rn-t/rogy-cnc-controller/PCB/cnc-controller.pdf

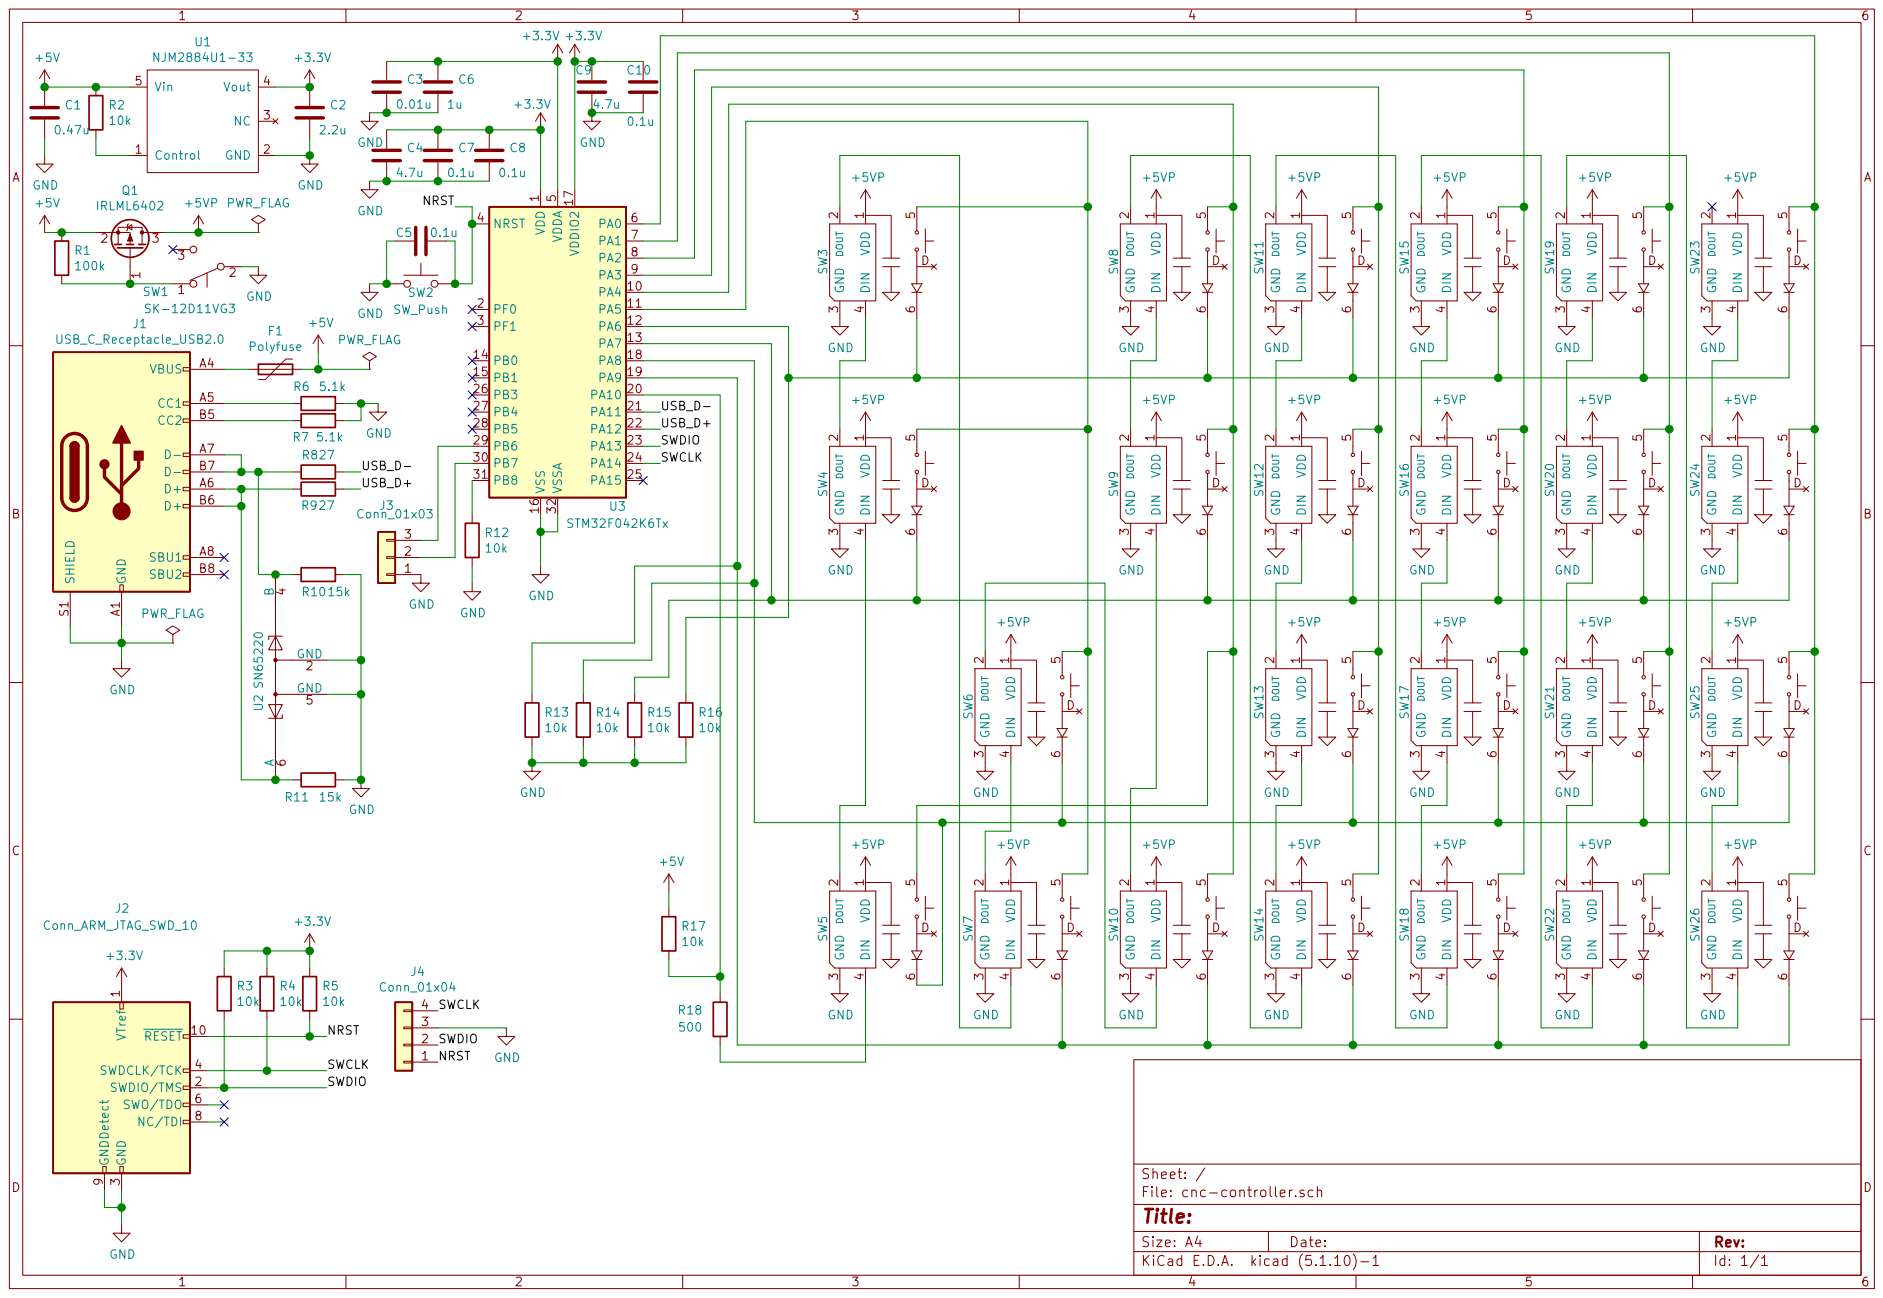
[picture p1: page 1]

Id: 1/1 Title: File: cnc-controller.sch Sheet: /
