rn-t/rogy-cnc-controller/PCB/cnc-controller.kicad_pcb

## KiCad design PCB/cnc-controller.kicad_pcb (2021-09-07)

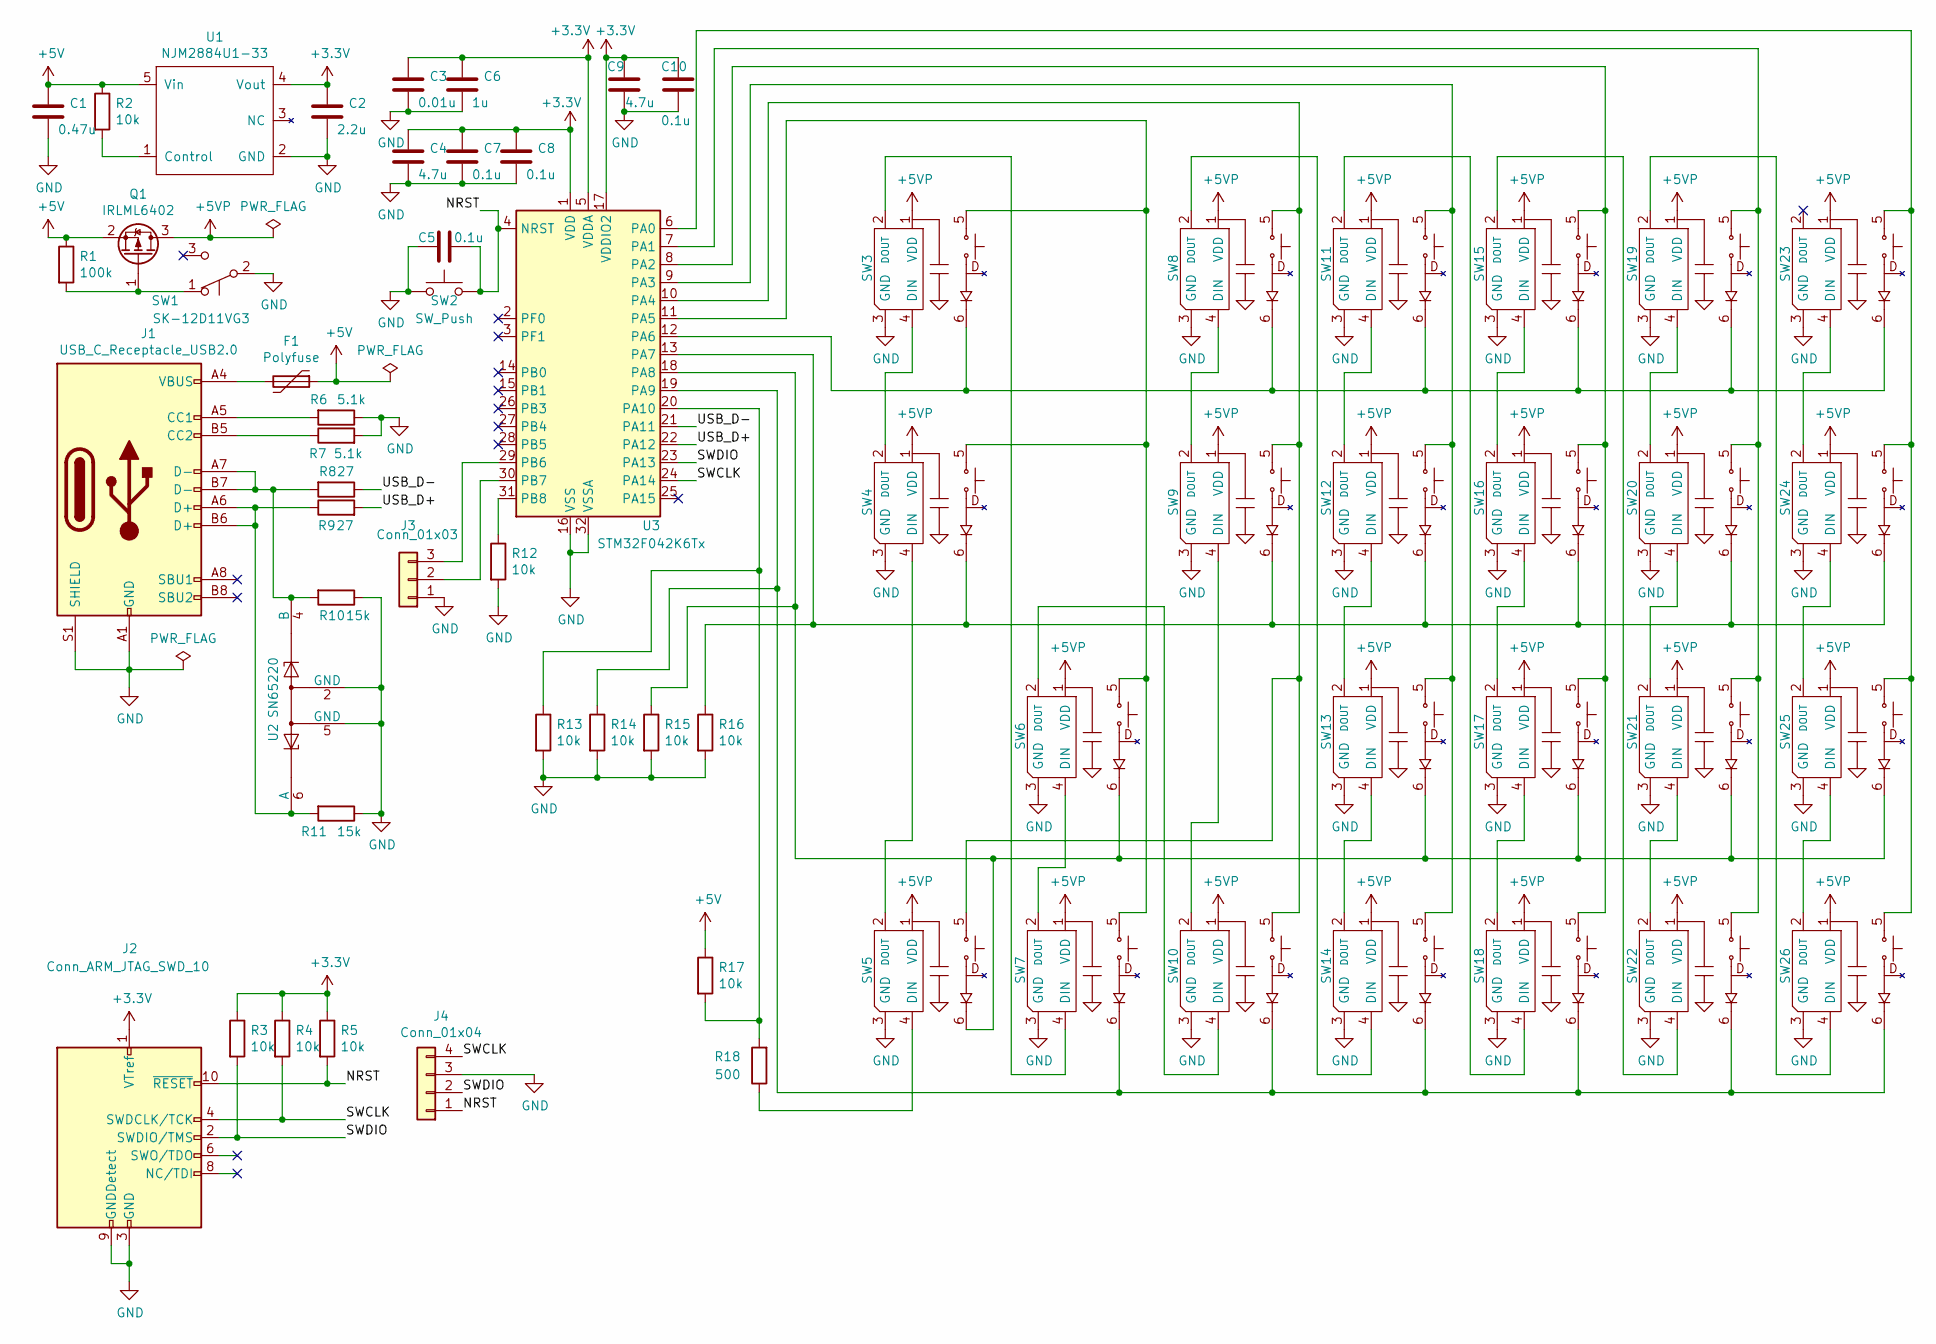
[picture p2: schematic cnc-controller.sch]

Parts:
C1: 0.47u; C_0402_1005Metric_Pad0.74x0.62mm_HandSolder
C2: 2.2u; C_0805_2012Metric_Pad1.18x1.45mm_HandSolder
C3: 0.01u; C_0603_1608Metric_Pad1.08x0.95mm_HandSolder
C4, C9: 4.7u; C_0603_1608Metric_Pad1.08x0.95mm_HandSolder
C5, C7, C8, C10: 0.1u; C_0603_1608Metric_Pad1.08x0.95mm_HandSolder
C6: 1u; C_0603_1608Metric_Pad1.08x0.95mm_HandSolder
F1: Polyfuse; Fuse_0603_1608Metric_Pad1.05x0.95mm_HandSolder
J1: USB_C_Receptacle_USB2.0; USBC_5077CR-16-SMC2-BK-TR
J2: Conn_ARM_JTAG_SWD_10; PinHeader_2x05_P1.27mm_Vertical
J3: Conn_01x03; PinHeader_1x03_P2.54mm_Vertical
J4: Conn_01x04; PinHeader_1x04_P2.54mm_Vertical
Q1: IRLML6402; SOT-23
R1: 100k; R_0603_1608Metric_Pad0.98x0.95mm_HandSolder
R2, R3, R4, R5, R12, R13, R14, R15, R16, R17: 10k; R_0603_1608Metric_Pad0.98x0.95mm_HandSolder
R6, R7: 5.1k; R_0603_1608Metric_Pad0.98x0.95mm_HandSolder
R8, R9: 27; R_0603_1608Metric_Pad0.98x0.95mm_HandSolder
R10, R11: 15k; R_0603_1608Metric_Pad0.98x0.95mm_HandSolder
R18: 500; R_0603_1608Metric_Pad0.98x0.95mm_HandSolder
SW1: SK-12D11VG3; SW_SK-12D11VG3
SW2: SW_Push; SW_TVBP06-B043CB-B
SW3, SW4, SW5, SW6, SW7, SW8, SW9, SW10, SW11, SW12, SW13, SW14, SW15, SW16, SW17, SW18, SW19, SW20, SW21, SW22, SW23, SW24, SW25, SW26: sw_unit; kailh_chocv1_unit
U1: NJM2884U1-33; SOT-89-5_Handsoldering
U2: SN65220; SOT-23-6
U3: STM32F042K6Tx; LQFP-32_7x7mm_P0.8mm

Connections:
+3V3: C2.1, C3.1, C4.1, C6.1, C7.1, C8.1, C9.1, C10.1, J2.1 (VTref), R3.1, R4.1, R5.1, U1.4 (Vout), U3.1 (VDD), U3.5 (VDDA), U3.17 (VDDIO2); also elsewhere on the board
+5V: C1.1, F1.1, Q1.2 (S), R1.1, R2.1, R17.1, U1.5 (Vin)
+5VP: Q1.3 (D), SW3.1 (VDD), SW4.1 (VDD), SW5.1 (VDD), SW6.1 (VDD), SW7.1 (VDD), SW8.1 (VDD), SW9.1 (VDD), SW10.1 (VDD), SW11.1 (VDD), SW12.1 (VDD), SW13.1 (VDD), SW14.1 (VDD), SW15.1 (VDD), SW16.1 (VDD), SW17.1 (VDD), SW18.1 (VDD), SW19.1 (VDD), SW20.1 (VDD), SW21.1 (VDD), SW22.1 (VDD), SW23.1 (VDD), SW24.1 (VDD), SW25.1 (VDD), SW26.1 (VDD)
/NRST: C5.1, J2.10 (~RESET~), J4.1, R5.2, SW2.2, U3.4 (NRST); also elsewhere on the board
/SWCLK: J2.4 (SWDCLK/TCK), J4.4, R4.2, U3.24 (PA14); also elsewhere on the board
/SWDIO: J2.2 (SWDIO/TMS), J4.2, R3.2, U3.23 (PA13); also elsewhere on the board
/USB_D+: R9.2, U3.22 (PA12)
/USB_D-: R8.1, U3.21 (PA11)
GND: C1.2, C2.2, C3.2, C4.2, C5.2, C6.2, C7.2, C8.2, C9.2, C10.2, J1.A1 (GND), J1.A12 (GND), J1.B1 (GND), J1.B12 (GND), J1.S1 (SHIELD), J2.3 (GND), J2.5 (GND), J2.9 (GNDDetect), J3.1, J4.3, R6.1, R7.2, R10.1, R11.1, R12.2, R13.2, R14.2, R15.2, R16.2, SW1.2 (B), SW2.1, SW3.3 (GND), SW4.3 (GND), SW5.3 (GND), SW6.3 (GND), SW7.3 (GND), SW8.3 (GND), SW9.3 (GND), SW10.3 (GND), SW11.3 (GND), SW12.3 (GND), SW13.3 (GND), SW14.3 (GND), SW15.3 (GND), SW16.3 (GND), SW17.3 (GND), SW18.3 (GND), SW19.3 (GND), SW20.3 (GND), SW21.3 (GND), SW22.3 (GND), SW23.3 (GND), SW24.3 (GND), SW25.3 (GND), SW26.3 (GND), U1.2 (GND), U2.2 (GND), U2.5 (GND), U3.16 (VSS), U3.32 (VSSA); also elsewhere on the board
unnamed: F1.2, J1.A4 (VBUS), J1.A9 (VBUS), J1.B4 (VBUS), J1.B9 (VBUS)
unnamed: J1.A5 (CC1), R6.2
unnamed: J1.A6 (D+), J1.B6 (D+), R9.1, R11.2, U2.6 (A)
unnamed: J1.A7 (D-), J1.B7 (D-), R8.2, R10.2, U2.4 (B)
unnamed: J1.B5 (CC2), R7.1
unnamed 19: J3.2, U3.30 (PB7); also elsewhere on the board
unnamed 20: J3.3, U3.29 (PB6); also elsewhere on the board
unnamed: Q1.1 (G), R1.2, SW1.1 (A)
unnamed: R2.2, U1.1 (Control)
unnamed: R12.1, U3.31 (PB8)
unnamed: R13.1, R17.2, R18.2, U3.20 (PA10)
unnamed: R14.1, SW7.6, SW10.6, SW14.6, SW18.6, SW22.6, SW26.6, U3.19 (PA9)
unnamed: R15.1, SW5.6, SW6.6, SW13.6, SW17.6, SW21.6, SW25.6, U3.18 (PA8)
unnamed: R16.1, SW4.6, SW9.6, SW12.6, SW16.6, SW20.6, SW24.6, U3.13 (PA7)
unnamed: R18.1, SW5.4 (DIN)
unnamed: SW3.2 (DOUT), SW7.4 (DIN)
unnamed: SW3.4 (DIN), SW4.2 (DOUT)
unnamed: SW3.5, SW4.5, SW6.5, SW7.5, U3.11 (PA5)
unnamed: SW4.4 (DIN), SW5.2 (DOUT)
unnamed: SW6.4 (DIN), SW7.2 (DOUT)
unnamed: SW8.4 (DIN), SW9.2 (DOUT)
unnamed: SW9.4 (DIN), SW10.2 (DOUT)
unnamed: SW6.2 (DOUT), SW10.4 (DIN)
unnamed: SW5.5, SW8.5, SW9.5, SW10.5, U3.10 (PA4)
unnamed: SW11.2 (DOUT), SW18.4 (DIN)
unnamed: SW11.4 (DIN), SW12.2 (DOUT)
unnamed: SW11.5, SW12.5, SW13.5, SW14.5, U3.9 (PA3)
unnamed: SW3.6, SW8.6, SW11.6, SW15.6, SW19.6, SW23.6, U3.12 (PA6)
unnamed: SW12.4 (DIN), SW13.2 (DOUT)
unnamed: SW13.4 (DIN), SW14.2 (DOUT)
unnamed: SW8.2 (DOUT), SW14.4 (DIN)
unnamed: SW15.2 (DOUT), SW22.4 (DIN)
unnamed: SW15.4 (DIN), SW16.2 (DOUT)
unnamed: SW15.5, SW16.5, SW17.5, SW18.5, U3.8 (PA2)
unnamed: SW16.4 (DIN), SW17.2 (DOUT)
unnamed: SW17.4 (DIN), SW18.2 (DOUT)
unnamed: SW19.2 (DOUT), SW26.4 (DIN)
unnamed: SW19.4 (DIN), SW20.2 (DOUT)
unnamed: SW19.5, SW20.5, SW21.5, SW22.5, U3.7 (PA1)
unnamed: SW20.4 (DIN), SW21.2 (DOUT)
unnamed: SW21.4 (DIN), SW22.2 (DOUT)
unnamed: SW23.4 (DIN), SW24.2 (DOUT)
unnamed: SW23.5, SW24.5, SW25.5, SW26.5, U3.6 (PA0)
unnamed: SW24.4 (DIN), SW25.2 (DOUT)
unnamed: SW25.4 (DIN), SW26.2 (DOUT)

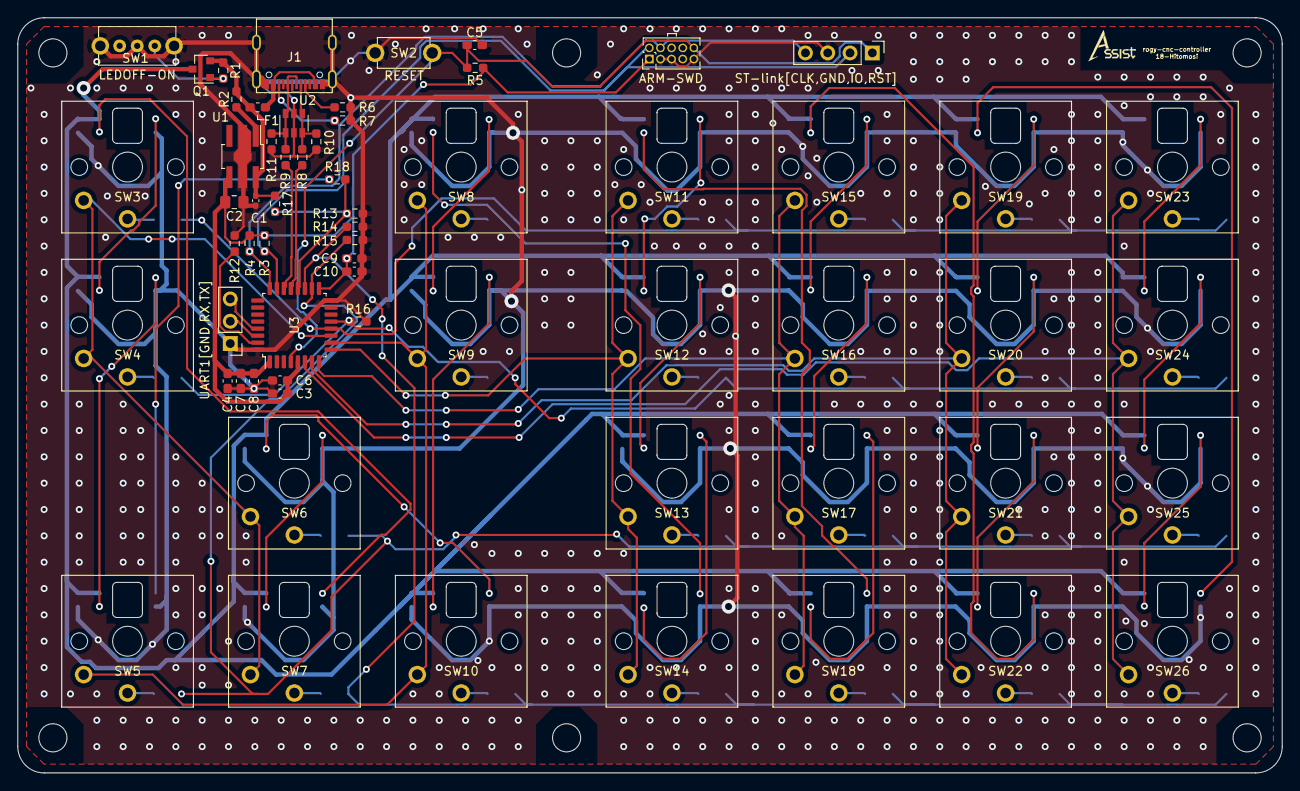
[picture p3: board cnc-controller.kicad_pcb from above]

Board: 2 copper layers, 144.0 x 86.0 mm, 63 parts (0 on the bottom side), 54 nets.

Other parts of the board:
ARM-SWD: Conn_ARM_JTAG_SWD_10; PinHeader_2x05_P1.27mm_Vertical
ST-link[CLK,GND,IO,RST]: Conn_01x04; PinHeader_1x04_P2.54mm_Vertical
UART1[GND,RX,TX]: Conn_01x03; PinHeader_1x03_P2.54mm_Vertical

Their connections:
+3V3: ARM-SWD.1; also elsewhere on the board
/NRST: ARM-SWD.10, ST-link[CLK,GND,IO,RST].1; also elsewhere on the board
/SWCLK: ARM-SWD.4, ST-link[CLK,GND,IO,RST].4; also elsewhere on the board
/SWDIO: ARM-SWD.2, ST-link[CLK,GND,IO,RST].2; also elsewhere on the board
GND: ARM-SWD.3, ARM-SWD.5, ARM-SWD.9, ST-link[CLK,GND,IO,RST].3, UART1[GND,RX,TX].1; also elsewhere on the board
unnamed 19: UART1[GND,RX,TX].2; also elsewhere on the board
unnamed 20: UART1[GND,RX,TX].3; also elsewhere on the board
