rn-t/rogy-cnc-controller/firmware/Core/Src/main.c

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
/* Includes ------------------------------------------------------------------*/
#include "main.h"
#include "usb_device.h"

/* USER CODE BEGIN Includes */
#include "sk6812mini-e.h"
#include "serttings.h"
/* USER CODE END Includes */

TIM_HandleTypeDef htim1;
TIM_HandleTypeDef htim14;
DMA_HandleTypeDef hdma_tim1_ch3_up;

/* USER CODE BEGIN PV */
static volatile uint8_t interrupt;
extern USBD_HandleTypeDef hUsbDeviceFS;
/* USER CODE END PV */

void SystemClock_Config(void);
static void MX_GPIO_Init(void);
static void MX_DMA_Init(void);
static void MX_TIM14_Init(void);
static void MX_TIM1_Init(void);
/* USER CODE BEGIN 0 */
void HAL_TIM_PeriodElapsedCallback(TIM_HandleTypeDef *htim) {
	if (htim->Instance == TIM14) {
		interrupt = 1;
	}
}

void updateLED(){
	uint8_t LED[72];
	const uint8_t LEDorder[24] = {13,6,0,18,12,19,1,7,20,14,8,2,21,15,9,3,22,16,10,4,23,17,11,5};
	for(int i = 0; i < 24; i++){
		for(int j = 0; j < 3; j++){
			LED[i*3 + j] = LEDsettings[LEDorder[i]][j];
		}
	}
    sk6812miniE_start (LED, sizeof (LED), true);
}
/* USER CODE END 0 */

/**
  * @brief  The application entry point.
  * @retval int
  */
int main(void)
{
  /* USER CODE BEGIN 1 */
  interrupt = 0;

  //Define struct for USB Report.
  struct keyboardHID_t {
	  uint8_t modifiers;
	  uint8_t reserved;
	  uint8_t key[6];
  };

  /* USER CODE END 1 */

  /* MCU Configuration--------------------------------------------------------*/

  /* Reset of all peripherals, Initializes the Flash interface and the Systick. */
  HAL_Init();

  /* Configure the system clock */
  SystemClock_Config();

  /* Initialize all configured peripherals */
  MX_GPIO_Init();
  MX_DMA_Init();
  MX_TIM14_Init();
  MX_USB_DEVICE_Init();
  MX_TIM1_Init();
  /* USER CODE BEGIN 2 */
  HAL_TIM_Base_Start_IT(&htim14);
  sk6812miniE_init (&htim1, TIM_CHANNEL_3);
  /* USER CODE END 2 */

  /* Infinite loop */
  /* USER CODE BEGIN WHILE */
  while (1)
  {
      while(interrupt == 0);
      interrupt = 0;
      updateLED();
	  //Declaration,initialization struct for USB Report.
	  struct keyboardHID_t keyboardHID;
	  keyboardHID.modifiers = 0;
	  keyboardHID.reserved = 0;
	  for(int i = 0 ;i < 6; i++){
		  keyboardHID.key[i] = 0;
	  }

      //Set keycodes and modifiers of keyboardHID correspond to the state of keymatrix.
      //The maximum number of keys that can be pressed simultaneously is 6.
      int numOfKey = 0;
      for(int row=0;row<6;row++){
          const uint16_t inpin[4] = {GPIO_PIN_6,GPIO_PIN_7,GPIO_PIN_8,GPIO_PIN_9};
          const uint16_t outpin[6] = {GPIO_PIN_5,GPIO_PIN_4,GPIO_PIN_3,GPIO_PIN_2,GPIO_PIN_1,GPIO_PIN_0};
    	  for(int i=0;i<6;i++){
    		  if(i==row)HAL_GPIO_WritePin(GPIOA,outpin[i],GPIO_PIN_SET);
    	  	  else HAL_GPIO_WritePin(GPIOA,outpin[i],GPIO_PIN_RESET);
    	  }
    	  for(int line=0;line<4;line++){
    		  if(HAL_GPIO_ReadPin(GPIOA,inpin[line]) == GPIO_PIN_SET){
				  keyboardHID.key[numOfKey] = keycodes[line][row];
				  keyboardHID.modifiers |= modifiers[line][row];
				  numOfKey++;
				  if(numOfKey>=6)break;
              }
          }
          if(numOfKey>=6)break;
      }

      USBD_HID_SendReport(&hUsbDeviceFS, &keyboardHID, sizeof(struct keyboardHID_t));
    /* USER CODE END WHILE */

    /* USER CODE BEGIN 3 */
  }
  /* USER CODE END 3 */
}

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
