rn-t/rogy-cnc-controller/firmware/firmware.ioc

Mcu.UserName=STM32F042K6Ux
PA13.Signal=SYS_SWDIO
PA12.Signal=USB_DP
PA9.Signal=GPIO_Input
PA1.Signal=GPIO_Output
PA5.Signal=GPIO_Output
PA8.Signal=GPIO_Input
PA2.Signal=GPIO_Output
PA0.Signal=GPIO_Output
PA4.Signal=GPIO_Output
PA6.Signal=GPIO_Input
PA11.Signal=USB_DM
PA10.Signal=S_TIM1_CH3
PA14.Signal=SYS_SWCLK
PA3.Signal=GPIO_Output
PA7.Signal=GPIO_Input
