rn-t/rogy-cnc-controller/(commit log)

2021-08-11 キーマトリクスとLEDの回路図を作成
    [cnc-controller.sch]
2021-08-13 USBのデータ線の保護素子を変更 USB周りの配線を変更及び書き直し
    [cnc-controller.sch]
2021-08-14 3.3Vレギュレータを追加 マイコンの電源用コンデンサを追加 VBUS付近にPWR_FLAGを追加
    [cnc-controller.sch]
2021-08-14 USB-Cコネクタのフットプリントを作成し、追加
2021-08-15 キースイッチのフットプリントを作成
2021-08-15 キーマトリクスにプルダウン抵抗を追加 LED電源用スイッチの回路を追加
    [cnc-controller.sch]
2021-08-16 リセットスイッチを追加 キーユニットに作図補助線を追加 スイッチ用のフットプリント2つ(トグルスイッチとプッシュスイッチ)用を作成
    [cnc-controller.sch]
2021-08-16 フットプリントの関連付けを行った
    [cnc-controller.sch]
2021-08-17 回路図上USBコネクタを2.0用のものに変更
    [cnc-controller.sch]
2021-08-17 基板の作成を開始 あらかた終了したが、外形線との間隔をあける必要あり
    [cnc-controller.kicad_pcb, cnc-controller.sch]
2021-08-18 基板の配線が終了。ねじ穴を開けるために一部変更する必要あり。
    [cnc-controller.kicad_pcb]
2021-08-19 基板が完成 ロゴを追加 ガーバーファイルを追加 gitignoreをzipを無視するように変更
    [cnc-controller.kicad_pcb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]
2021-09-05 fixed comment in keymap.h
    [keymap.h]
2021-09-06 Fixed the place of hUsbDeviceFS declaration in main.c
    [main.c]
2021-09-06 PCBが完成
    [cnc-controller.kicad_pcb]
2021-09-07 remove "#include "keymatrix"" because it's no longer used.
    [main.c]
2021-09-09 Enable timer interrupt
2021-09-09 fixed comments in main.c
    [main.c]
2021-09-09 change PA10 and TIM1 settings PA10->TIM1_CH3, OpenDrain TIM1 CH3 -> PWM generation
2021-09-09 change report rate 1000Hz
2021-09-09 change settings about TIM1_CH3 Counter Period, DMA
2021-10-15 change DMA settings HALFWORD->BYTE & NORMAL->CIRCULAR
2021-10-15 add codes to light LEDs for test
2021-10-27 回路図のpdfを追加
2021-10-27 回路図を修正
    [cnc-controller.sch]
2021-10-27 add explanation about LEDs in README.md
2022-03-06 change polling rate 1000Hz -> 100Hz
