rn-t/rogy-cnc-controller/(notices)

Notices in the files:
firmware/Core/Src/main.c:
© Copyright (c) 2021 STMicroelectronics.
All rights reserved.
This software component is licensed by ST under Ultimate Liberty license
(C) COPYRIGHT STMicroelectronics *****END OF FILE
